azlan-works/nano-w/README.md

# nano-w
A tiny RP2354A based dev board with WiFi and BLE

edited-photo
