azlan-works/nano-w/nano-w.step

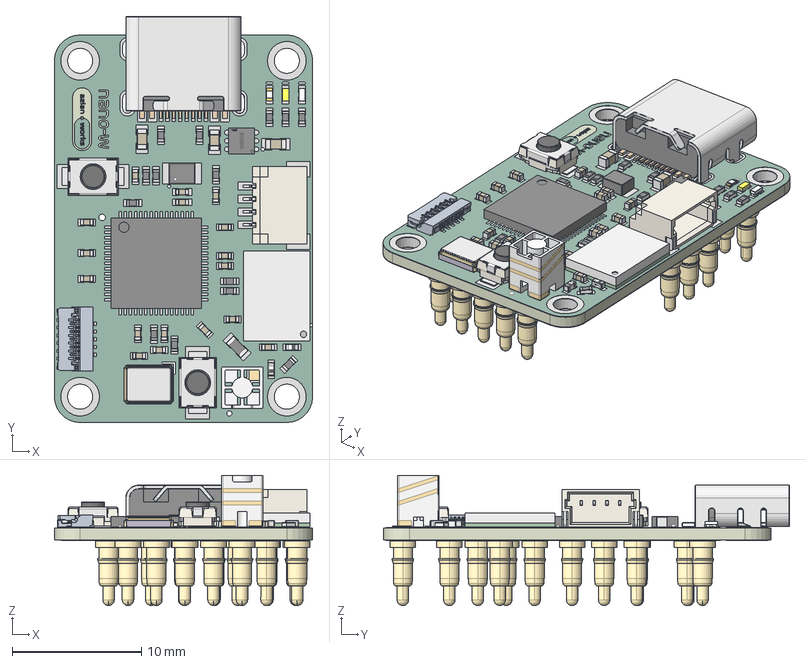
[picture p1: CAD file, 2026-09-20]
nano-w.step
20.0 x 31.4 x 10.1 mm
CRYSTAL-SMD_4P-L3.2-W2.5-BL.step
L0402-RD x 2
LGA-46_L7.0-W5.2_LBEE5KL1DX-883.step
LED0402_L1.0-W0.5-H0.2
R0402_L1.0-W0.5-H0.4.step x 14
RP2350A-QFN60
ANT-SMD_L3.2-W3.2-H4.0.step
LED0402-R-RD_GREEN
SW-SMD_L3.9-W2.9-H2.0-LS4.8.step x 2
IND-SMD_L2.0-W1.6_AOTA-B201610S3R3-101-T
USB-C_SMD-TYPE-C-31-M-12_1.step
WSON-6_L2.0-W2.0-H0.8-P0.65
CONN-SMD_SR1.00-WS-4P.step
L0603_L1.6-W0.8-H0.5_BEAD
LED-SMD_L1.0-W0.5-RD_WHITE
TESTPOINT-SMD_BD2.0_C9900030651 x 19
nano-w_copper
nano-w_pad
nano-w_via
nano-w_silkscreen x 2
nano-w_soldermask x 2
nano-w_PCB
