azlan-works/nano-w/nano-w.kicad_pcb

## KiCad design nano-w.kicad_pcb (2026-09-20)

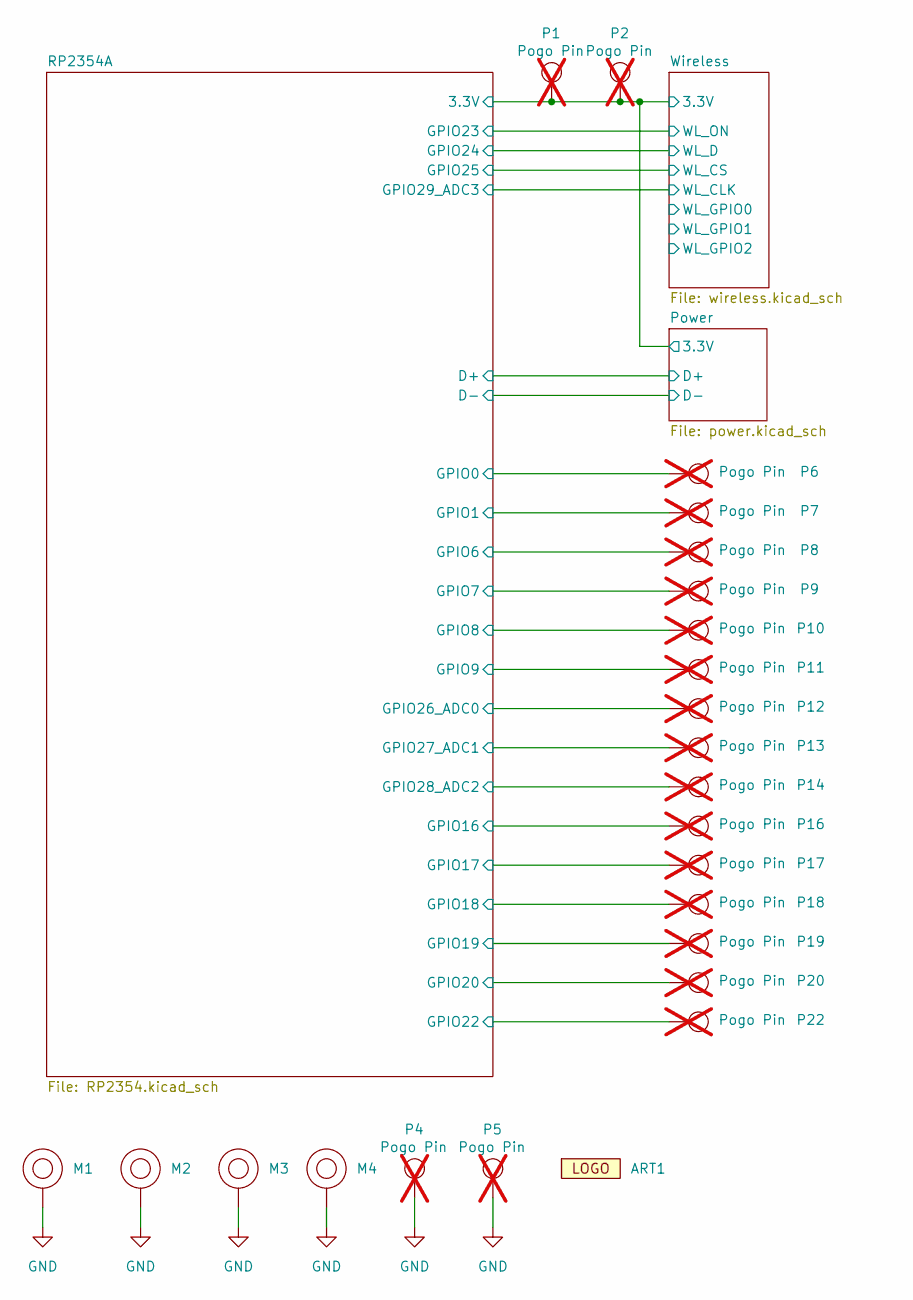
[picture p2: schematic nano-w.kicad_sch]

Parts:
ART1: azlan.works_logo
M1, M2, M3, M4: M2_Hole
P1, P2, P4, P5, P6, P7, P8, P9, P10, P11, P12, P13, P14, P16, P17, P18, P19, P20, P22: Pogo Pin; TESTPOINT-SMD_BD2.0_C9900030651; MPN YTC1P-3010-01; LCSC Part C5221282; not fitted

Connections:
+3V3: P1.1 (1_1), P2.1 (1_1); also elsewhere on the board
/RP2354A/GPIO6: P8.1 (1_1); also elsewhere on the board
/RP2354A/GPIO7: P9.1 (1_1); also elsewhere on the board
/RP2354A/GPIO8: P10.1 (1_1); also elsewhere on the board
/RP2354A/GPIO9: P11.1 (1_1); also elsewhere on the board
/RP2354A/GPIO16: P16.1 (1_1); also elsewhere on the board
/RP2354A/GPIO17: P17.1 (1_1); also elsewhere on the board
/RP2354A/GPIO18: P18.1 (1_1); also elsewhere on the board
/RP2354A/GPIO19: P19.1 (1_1); also elsewhere on the board
/RP2354A/GPIO20: P20.1 (1_1); also elsewhere on the board
/RP2354A/GPIO22: P22.1 (1_1); also elsewhere on the board
/RP2354A/GPIO26_ADC0: P12.1 (1_1); also elsewhere on the board
/RP2354A/GPIO27_ADC1: P13.1 (1_1); also elsewhere on the board
/RP2354A/GPIO28_ADC2: P14.1 (1_1); also elsewhere on the board
GND: M1.1 (1_1), M2.1 (1_1), M3.1 (1_1), M4.1 (1_1), P4.1 (1_1), P5.1 (1_1); also elsewhere on the board

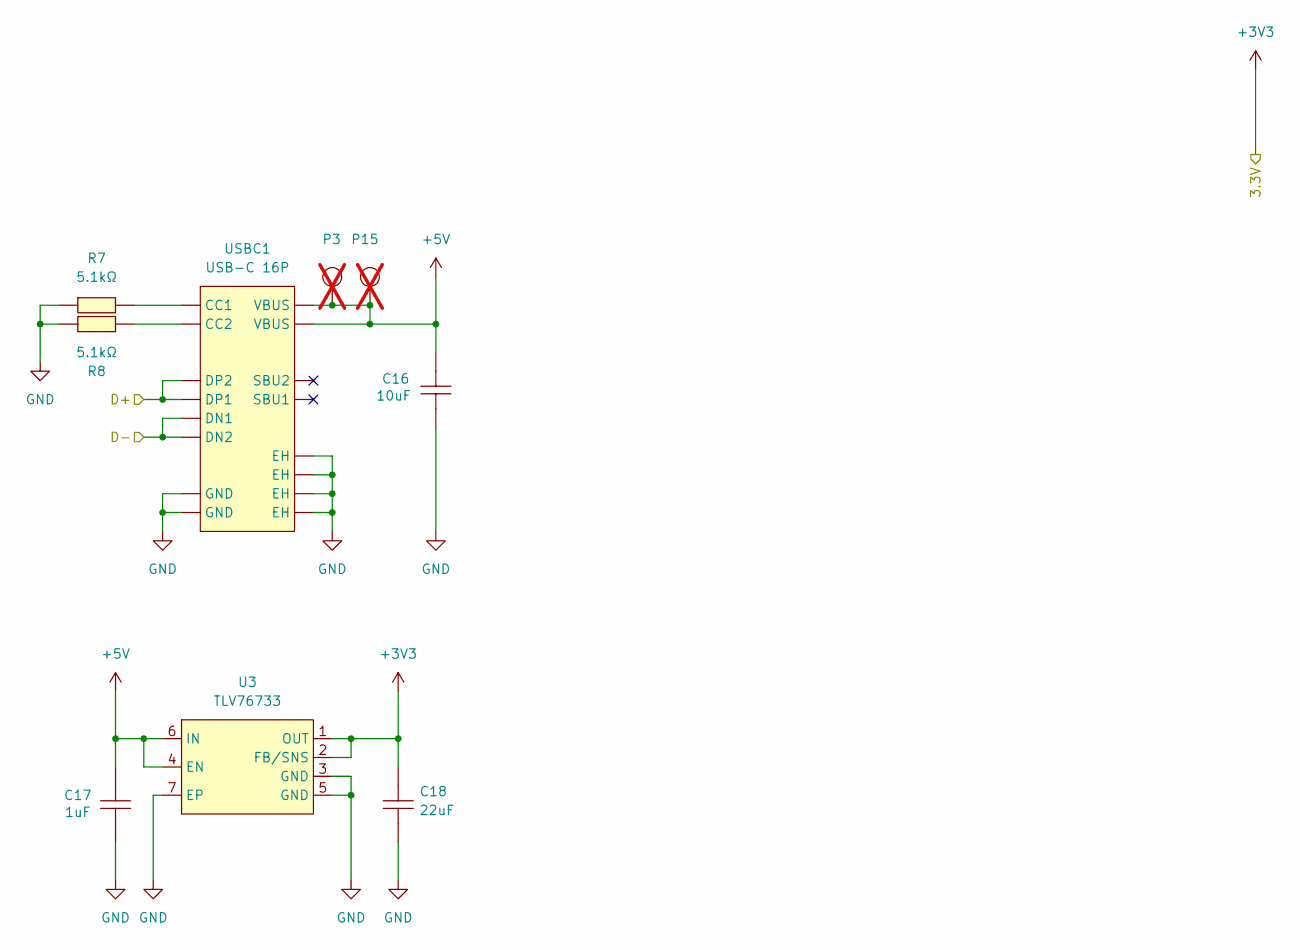
[picture p3: schematic power.kicad_sch]

Parts:
C16: 10uF; C0603; MPN CL10A106MA8NRNC; LCSC Part C96446
C17: 1uF; C0603; MPN CL10A105KB8NNNC; LCSC Part C15849
C18: 22uF; C0603; MPN CL10A226MQ8NRNC; LCSC Part C59461
P3, P15: Pogo Pin; TESTPOINT-SMD_BD2.0_C9900030651; MPN YTC1P-3010-01; LCSC Part C5221282; not fitted
R7, R8: 5.1kΩ; R0402; MPN 0402WGF5101TCE; LCSC Part C25905
U3: TLV76733; WSON-6_L2.0-W2.0-P0.65-TL-EP; MPN TLV76733DRVR; LCSC Part C2848334
USBC1: USB-C 16P; USB-C_SMD-TYPE-C-31-M-12_1; MPN TYPE-C-31-M-12; LCSC Part C165948

Connections:
+3V3: C18.2, U3.1 (OUT), U3.2 (FB/SNS); also elsewhere on the board
+5V: C16.2, C17.2, P3.1 (1_1), P15.1 (1_1), U3.4 (EN), U3.6 (IN), USBC1.A4B9 (VBUS), USBC1.B4A9 (VBUS)
/Power/D+: USBC1.A6 (DP1), USBC1.B6 (DP2); also elsewhere on the board
/Power/D-: USBC1.A7 (DN1), USBC1.B7 (DN2); also elsewhere on the board
GND: C16.1, C17.1, C18.1, R7.1, R8.1, U3.3 (GND), U3.5 (GND), U3.7 (EP), USBC1.1 (EH), USBC1.2 (EH), USBC1.3 (EH), USBC1.4 (EH), USBC1.A1B12 (GND), USBC1.B1A12 (GND); also elsewhere on the board
unnamed: R7.2, USBC1.A5 (CC1)
unnamed: R8.2, USBC1.B5 (CC2)

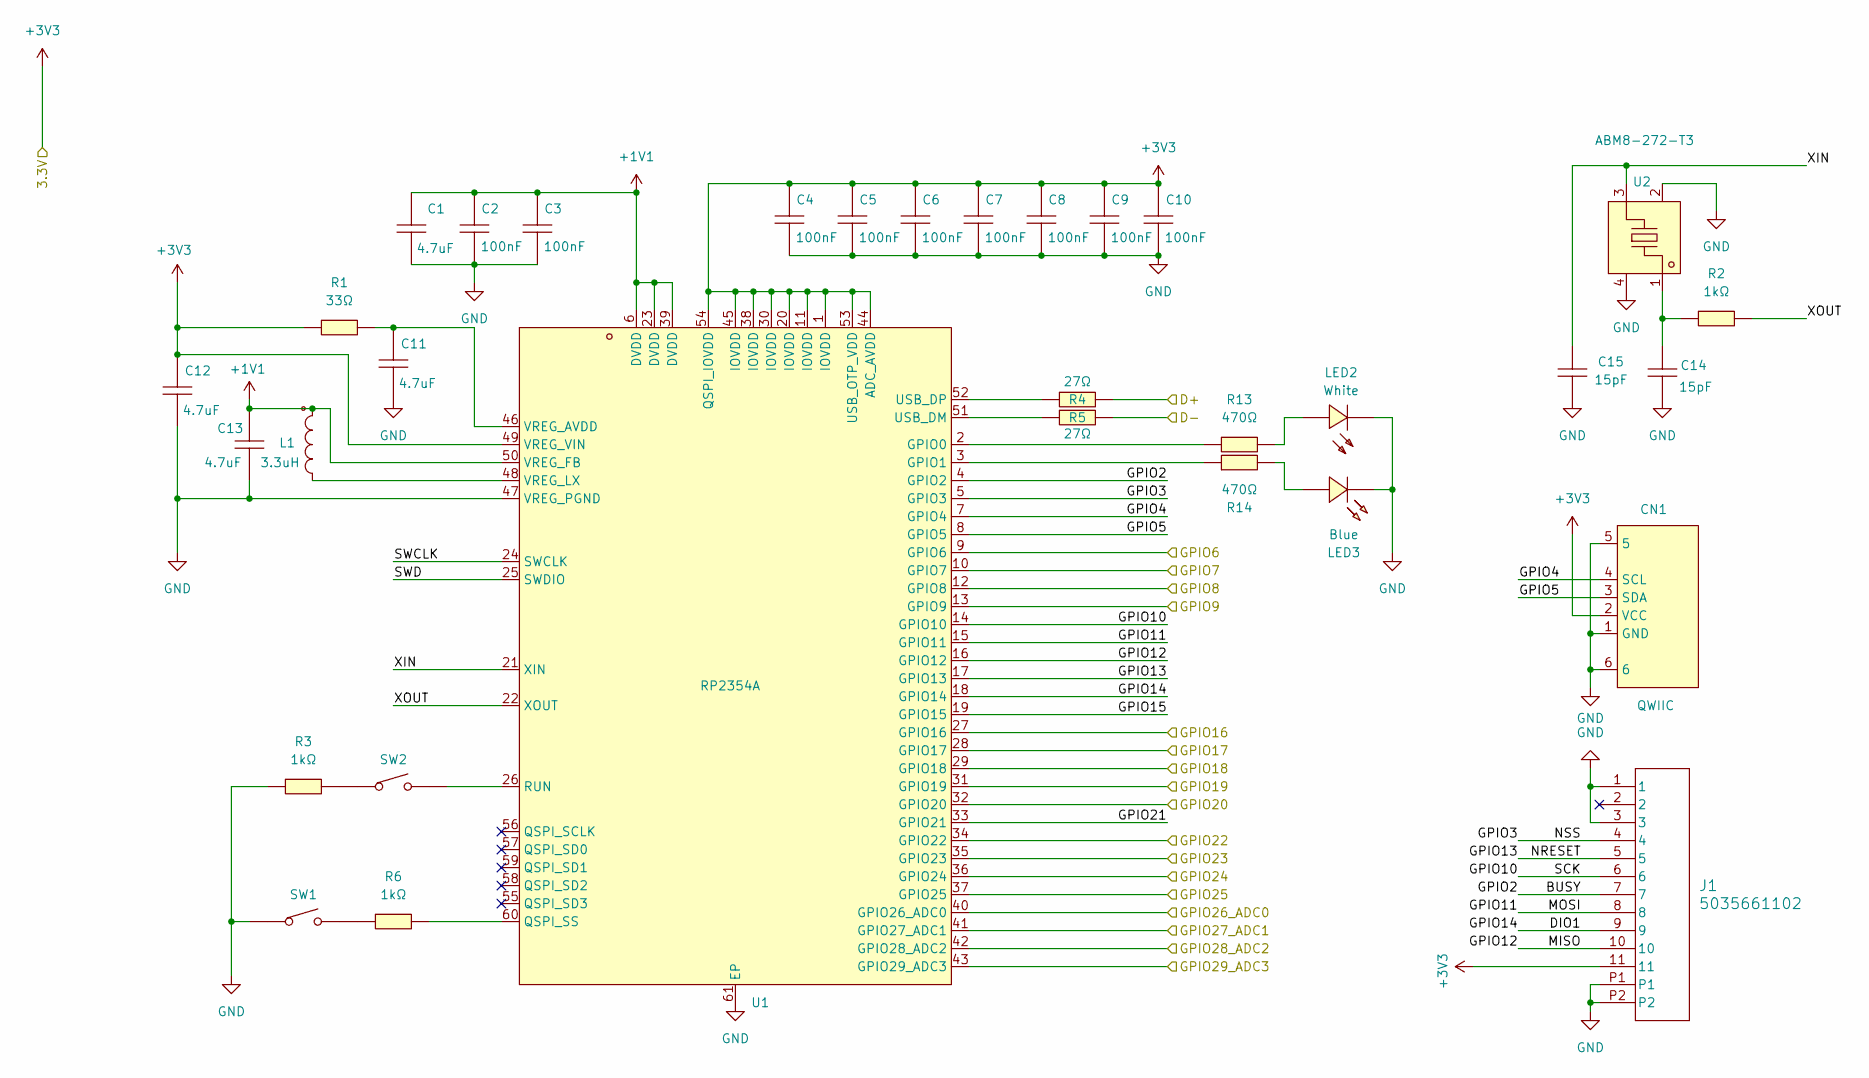
[picture p4: schematic RP2354.kicad_sch]

Parts:
C1, C11: 4.7uF; C0402; MPN CL05A475MP5NRNC; LCSC Part C23733
C2, C3, C4, C5, C6, C7, C8, C9, C10: 100nF; C0402; MPN CL05B104KB54PNC; LCSC Part C307331
C12, C13: 4.7uF; C0402_WIDE; MPN CL05A475MP5NRNC; LCSC Part C23733
C14, C15: 15pF; C0402; MPN 0402CG150J500NT; LCSC Part C1548
CN1: QWIIC; CONN-SMD_4P-P1.00_SM04B-SRSS-TB-LF-SN; MPN SM04B-SRSS-TB(LF)(SN); LCSC Part C160404
J1: 5035661102; CON_5035661102_MOL; MPN 503566-1102; LCSC Part C3036270
L1: 3.3uH; IND-SMD_L2.0-W1.6_AOTA-B201610S3R3-101-T; MPN AOTA-B201610S3R3-101-T; LCSC Part C42411119
LED2: White; LED-SMD_L1.0-W0.5-RD_WHITE; MPN LTW-C281DS5; LCSC Part C157742
LED3: Blue; LED0402-RD_BLUE; MPN LTST-C281TBKT-5A; LCSC Part C364550
R1: 33Ω; R0402; MPN 0402WGF330JTCE; LCSC Part C25105
R2, R3, R6: 1kΩ; R0402; MPN 0402WGF1001TCE; LCSC Part C11702
R4, R5: 27Ω; R0402; MPN 0402WGF270JTCE; LCSC Part C25100
R13, R14: 470Ω; R0402; MPN 0402WGF4700TCE; LCSC Part C25117
SW1, SW2: Button; SW-SMD_L3.9-W3.0-P4.45; MPN TS-1088-AR02016; LCSC Part C720477
U1: RP2354A; QFN-60_L7.0-W7.0-P0.40-TL-EP3.4; MPN RP2354A; LCSC Part C41378174
U2: ABM8-272-T3; CRYSTAL-SMD_4P-L3.2-W2.5-BL; MPN ABM8-272-T3; LCSC Part C20625731

Connections:
+1V1: C1.2, C2.2, C3.2, C13.2, L1.1, U1.6 (DVDD), U1.23 (DVDD), U1.39 (DVDD), U1.50 (VREG_FB)
+3V3: C4.2, C5.2, C6.2, C7.2, C8.2, C9.2, C10.2, C12.2, CN1.2 (VCC), J1.11, R1.1, U1.1 (IOVDD), U1.11 (IOVDD), U1.20 (IOVDD), U1.30 (IOVDD), U1.38 (IOVDD), U1.44 (ADC_AVDD), U1.45 (IOVDD), U1.49 (VREG_VIN), U1.53 (USB_OTP_VDD), U1.54 (QSPI_IOVDD); also elsewhere on the board
/Power/D+: R4.2; also elsewhere on the board
/Power/D-: R5.2; also elsewhere on the board
/RP2354A/BUSY: J1.7, U1.4 (GPIO2)
/RP2354A/DIO1: J1.9, U1.18 (GPIO14)
/RP2354A/GPIO3: J1.4, U1.5 (GPIO3)
/RP2354A/GPIO4: CN1.4 (SCL), U1.7 (GPIO4)
/RP2354A/GPIO5: CN1.3 (SDA), U1.8 (GPIO5)
/RP2354A/GPIO6: U1.9 (GPIO6); also elsewhere on the board
/RP2354A/GPIO7: U1.10 (GPIO7); also elsewhere on the board
/RP2354A/GPIO8: U1.12 (GPIO8); also elsewhere on the board
/RP2354A/GPIO9: U1.13 (GPIO9); also elsewhere on the board
/RP2354A/GPIO10: J1.6, U1.14 (GPIO10)
/RP2354A/GPIO11: J1.8, U1.15 (GPIO11)
/RP2354A/GPIO12: J1.10, U1.16 (GPIO12)
/RP2354A/GPIO13: J1.5, U1.17 (GPIO13)
/RP2354A/GPIO15: U1.19 (GPIO15)
/RP2354A/GPIO16: U1.27 (GPIO16); also elsewhere on the board
/RP2354A/GPIO17: U1.28 (GPIO17); also elsewhere on the board
/RP2354A/GPIO18: U1.29 (GPIO18); also elsewhere on the board
/RP2354A/GPIO19: U1.31 (GPIO19); also elsewhere on the board
/RP2354A/GPIO20: U1.32 (GPIO20); also elsewhere on the board
/RP2354A/GPIO21: U1.33 (GPIO21)
/RP2354A/GPIO22: U1.34 (GPIO22); also elsewhere on the board
/RP2354A/GPIO23: U1.35 (GPIO23); also elsewhere on the board
/RP2354A/GPIO24: U1.36 (GPIO24); also elsewhere on the board
/RP2354A/GPIO25: U1.37 (GPIO25); also elsewhere on the board
/RP2354A/GPIO26_ADC0: U1.40 (GPIO26_ADC0); also elsewhere on the board
/RP2354A/GPIO27_ADC1: U1.41 (GPIO27_ADC1); also elsewhere on the board
/RP2354A/GPIO28_ADC2: U1.42 (GPIO28_ADC2); also elsewhere on the board
/RP2354A/GPIO29_ADC3: U1.43 (GPIO29_ADC3); also elsewhere on the board
/RP2354A/SWCLK: U1.24 (SWCLK)
/RP2354A/SWD: U1.25 (SWDIO)
/RP2354A/XIN: C15.1, U1.21 (XIN), U2.3
/RP2354A/XOUT: R2.2, U1.22 (XOUT)
GND: C1.1, C2.1, C3.1, C4.1, C5.1, C6.1, C7.1, C8.1, C9.1, C10.1, C11.1, C12.1, C13.1, C14.2, C15.2, CN1.1 (GND), CN1.5, CN1.6, J1.1, J1.3, J1.P1, J1.P2, LED2.1 (-), LED3.1 (K), R3.1, SW1.1, U1.47 (VREG_PGND), U1.61 (EP), U2.2 (GND), U2.4 (GND); also elsewhere on the board
unnamed: C14.1, R2.1, U2.1
unnamed: LED2.2 (+), R13.2
unnamed: LED3.2 (A), R14.2
unnamed: R3.2, SW2.1
unnamed: R6.1, SW1.2
unnamed: R13.1, U1.2 (GPIO0)
unnamed: R14.1, U1.3 (GPIO1)
unnamed: R6.2, U1.60 (QSPI_SS)
unnamed: SW2.2, U1.26 (RUN)
unnamed: R5.1, U1.51 (USB_DM)
unnamed: R4.1, U1.52 (USB_DP)
unnamed: C11.2, R1.2, U1.46 (VREG_AVDD)
unnamed: L1.2, U1.48 (VREG_LX)

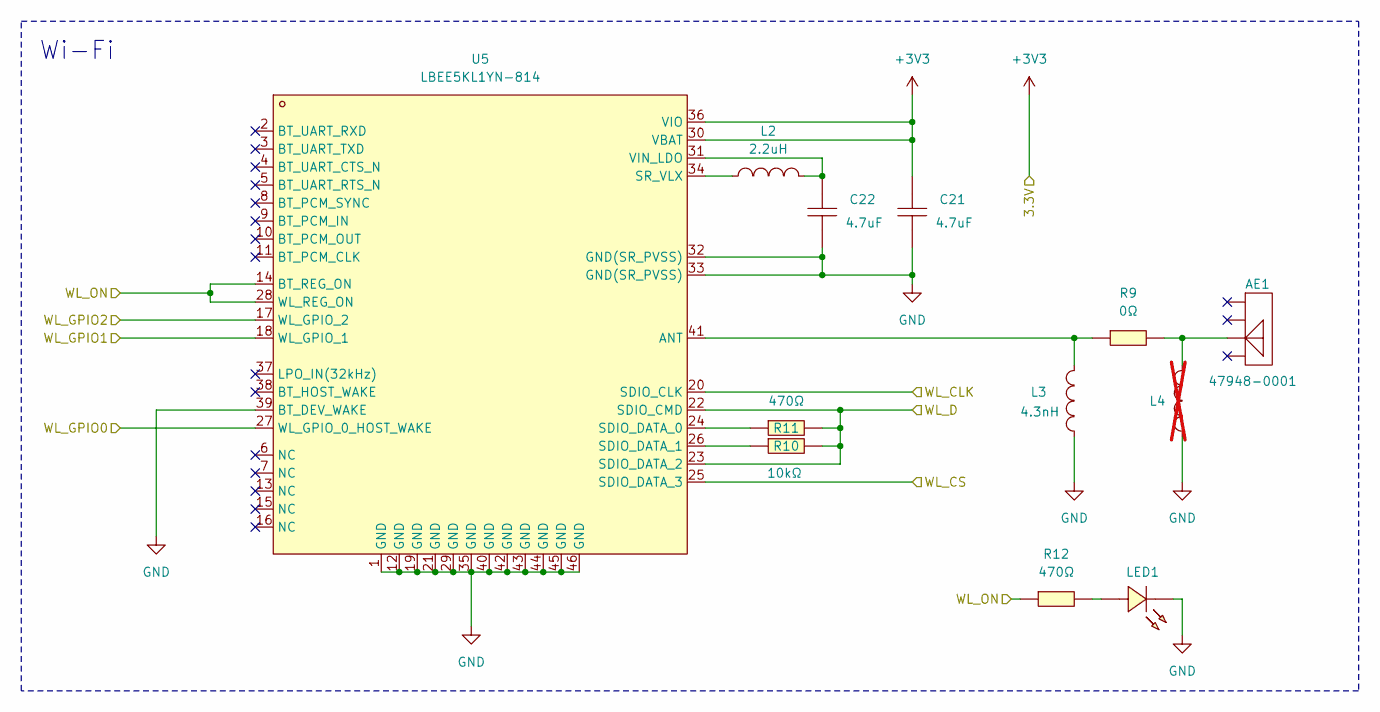
[picture p5: schematic wireless.kicad_sch]

Parts:
AE1: 47948-0001; ANT-SMD_47948-0001; MPN 47948-0001; LCSC Part C152351
C21, C22: 4.7uF; C0402; MPN CL05A475MP5NRNC; LCSC Part C23733
L2: 2.2uH; L0603; MPN LQM18PN2R2MFRL; LCSC Part C337910
L3: 4.3nH; L0402-RD; MPN MLG1005S4N3CT000; LCSC Part C275290
L4: 4.3nH; L0402-RD; MPN MLG1005S4N3CT000; LCSC Part C275290; not fitted
LED1: LTST-C281TGKT-5A; LED0402-R-RD_GREEN; MPN LTST-C281TGKT-5A; LCSC Part C364549
R9: 0Ω; R0402; MPN 0402WGF0000TCE; LCSC Part C17168
R10: 10kΩ; R0402; MPN 0402WGF1002TCE; LCSC Part C25744
R11, R12: 470Ω; R0402; MPN 0402WGF4700TCE; LCSC Part C25117
U5: LBEE5KL1YN-814; LGA-46_L7.0-W5.2_LBEE5KL1DX-883; MPN LBEE5KL1YN-814; LCSC Part C6583742

Connections:
+3V3: C21.2, U5.30 (VBAT), U5.36 (VIO); also elsewhere on the board
/RP2354A/GPIO23: R12.1, U5.14 (BT_REG_ON), U5.28 (WL_REG_ON); also elsewhere on the board
/RP2354A/GPIO24: R10.2, R11.2, U5.22 (SDIO_CMD), U5.23 (SDIO_DATA_2); also elsewhere on the board
/RP2354A/GPIO25: U5.25 (SDIO_DATA_3); also elsewhere on the board
/RP2354A/GPIO29_ADC3: U5.20 (SDIO_CLK); also elsewhere on the board
/Wireless/WL_GPIO0: U5.27 (WL_GPIO_0_HOST_WAKE)
/Wireless/WL_GPIO1: U5.18 (WL_GPIO_1)
/Wireless/WL_GPIO2: U5.17 (WL_GPIO_2)
GND: C21.1, C22.1, L3.2, L4.2, LED1.2 (K), U5.1 (GND), U5.12 (GND), U5.19 (GND), U5.21 (GND), U5.29 (GND), U5.32 (GND(SR_PVSS)), U5.33 (GND(SR_PVSS)), U5.35 (GND), U5.39 (BT_DEV_WAKE), U5.40 (GND), U5.42 (GND), U5.43 (GND), U5.44 (GND), U5.45 (GND), U5.46 (GND); also elsewhere on the board
unnamed: AE1.3 (3_3), L4.1, R9.2
unnamed: LED1.1 (A), R12.2
unnamed: L3.1, R9.1, U5.41 (ANT)
unnamed: R11.1, U5.24 (SDIO_DATA_0)
unnamed: R10.1, U5.26 (SDIO_DATA_1)
unnamed: L2.2, U5.34 (SR_VLX)
unnamed: C22.2, L2.1, U5.31 (VIN_LDO)

Notes on the sheet:
Wi-Fi

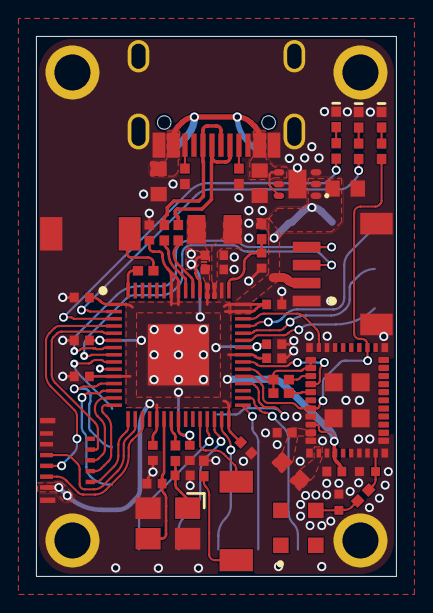
[picture p6: board nano-w.kicad_pcb from above]

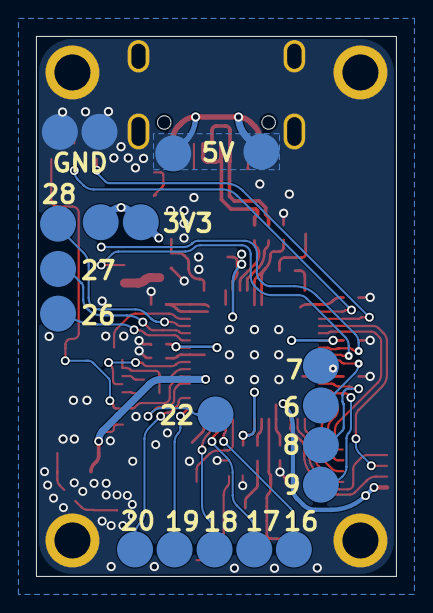
[picture p7: board nano-w.kicad_pcb from below]

Board: 4 copper layers, 20.0 x 30.0 mm, 76 parts (20 on the bottom side), 56 nets.

Other parts of the board:
ART1#2: azlan.works_logo
